minddot/hw/README.md

# MindDot Hardware

## Components

- ESP32-C3-WROOM-02
- AHT10
- LIS2DH12
- HX6306P332MR
