minddot/hw/esp32c3/esp32c3.kicad_pcb

## KiCad design esp32c3/esp32c3.kicad_pcb (2022-04-22)

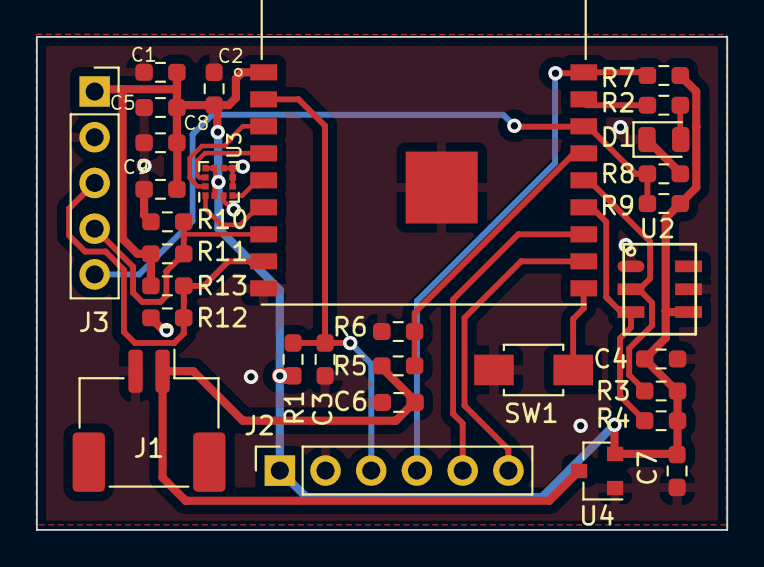
[picture p1: board esp32c3.kicad_pcb from above]

Board: 2 copper layers, 38.4 x 27.4 mm, 31 parts (0 on the bottom side), 20 nets.

Parts:
C1, C3, C5: 10uF; R_0603_1608Metric_Pad0.98x0.95mm_HandSolder
C2, C8, C9: 0.1uF; R_0603_1608Metric_Pad0.98x0.95mm_HandSolder
C4: 100nF; R_0603_1608Metric_Pad0.98x0.95mm_HandSolder
C6, C7: 1uF; R_0603_1608Metric_Pad0.98x0.95mm_HandSolder
D1: LED_RED; LED_0805_2012Metric
J1: A1501WR-S-2P; JST_ZE_BM02B-ZESS-TBT_1x02-1MP_P1.50mm_Vertical
J2: Conn_01x06; PinSocket_1x06_P2.54mm_Vertical
J3: Conn_01x05; PinSocket_1x05_P2.54mm_Vertical
R1: 12k; R_0603_1608Metric_Pad0.98x0.95mm_HandSolder
R2, R3, R4: 10k; R_0603_1608Metric_Pad0.98x0.95mm_HandSolder
R5, R8, R9, R10, R11, R12, R13: 100k; R_0603_1608Metric_Pad0.98x0.95mm_HandSolder
R6: 200k; R_0603_1608Metric_Pad0.98x0.95mm_HandSolder
R7: 5.1k; R_0603_1608Metric_Pad0.98x0.95mm_HandSolder
SW1: wake up; SW-SMD_2PIN-L4.05-W3.00-L
U1: ESP32-C3-WROOM-02
U2: AHT10
U3: LIS2DH; LGA-12_2x2mm_P0.5mm
U4: HX6306; SOT-23

Connections:
3.3V: C1.1, C2.1, C4.1, C5.1, C7.1, C8.1, C9.1, J2.1, J3.1, R1.1, R3.1, R4.1, R7.2, R9.2, R11.2, R13.2, U1.1 (3V3), U2.4 (VDD), U3.2 (~CS), U3.9 (Vdd), U3.10 (Vdd_IO), U4.2 (VOUT)
ADC: R5.2, R6.1, U1.15 (IO3)
EN: C3.1, J2.3, R1.2, U1.2 (EN)
GND: C1.2, C2.2, C3.2, C4.2, C5.2, C6.2, C7.2, C8.2, C9.2, D1.1 (K), J1.2, J2.2, J3.2, R6.2, R8.2, R10.2, R12.2, SW1.1, U1.9 (GND), U1.19 (GND), U2.1 (ADR), U2.5 (GND), U3.3 (SA0/SDO), U3.5 (RES), U3.6 (GND), U3.7 (GND), U3.8 (GND), U4.1 (GND)
INT: SW1.2, U1.10 (IO10)
INT1: U1.3 (IO4), U3.12 (INT1)
INT2: U1.4 (IO5), U3.11 (INT2)
IO0: J2.4, R7.1, U1.18 (IO0)
IO2: J3.5, R8.1, R9.1, U1.16 (IO2)
IO8: J3.4, R10.1, R11.1, U1.7 (IO8)
IO9: J3.3, R12.1, R13.1, U1.8 (IO9)
LED: R2.1, U1.17 (IO1)
unnamed: D1.2 (A), R2.2
RXD: J2.6, U1.11 (RXD)
SCL: U1.6 (IO7), U3.1 (SCL/SPC)
SCL_AHT10: R4.2, U1.13 (IO18), U2.3 (SCL)
SDA: U1.5 (IO6), U3.4 (SDA/SDI)
SDA_AHT10: R3.2, U1.14 (IO19), U2.2 (SDA)
TXD: J2.5, U1.12 (TXD)
V_In: C6.1, J1.1, R5.1, U4.3 (VIN)
