minddot/hw/(threads)

Thread 1 (2021-02-21):

[feature] getting started

bovi, 2021-02-21:
Add a getting started overview with the following content:

* how to add batteries
* how to connect the first-time
* how to access the web ui

bovi, 2021-12-08:
first schematic version checked in under: 7d61a6ebe9fcdbcbea0f9ce73e197d6e1afc682e

bovi, 2021-12-13:
push button, programming circuit fix and voltage measurement implemented under: 2b1e118047ebf2faca86f61bb3a7689e9192f407

bovi, 2021-12-22:
Review suggestions:

- R4 and R5 seem to be there in order to measure V_in. I suggest to make the values a little bit higher, in order to reduce the power consumption a bit. In the schematic, there would be more than 1mA continuously flowing through those resistors. Maybe 100k & 200k would be better?
- If we are short of IOs, it’s okay to leave INT2 of LIS2DH unconnected, but if we still have IOs free, we could also connect it.
- On page 8 of the AHT10 datasheet it says that the AHT10 can not be on the same i2c bus with other devices. Unless I am reading the datasheet wrong, we would have to create two i2c busses.
- According to the ESP datasheet, IO2, IO8 and IO9 are used for bootstrapping during boot, so I think we probably cannot use them in the way it’s done in the schematic. (See the section “Strapping Pins” in the datasheet.)
- I suggest to lead unused IOs to some pinheader pads so that we can easily access them, e.g.. for debugging purposes.
- An optional LED on one of the IOs might be nice.

Thread 3 (2021-02-21):

[doc] Add component datasheets

bovi, 2021-02-21:
Add datasheets of the used components.

bovi, 2021-09-14:
Datasheets for current LDO, Sensor and SoCs were uploaded. selection for SoC is still open.

Closed 2021-09-14.

Thread 4 (2021-09-13):

[doc] Add BOM

bovi, 2021-09-13:
Add BOM for the new open-hardware generation (SoC, Sensors, LDOs, etc.)

bovi, 2021-11-27:
added accelerometer, temperature sensor, LDO and SoC under [datasheets](https://github.com/minddot/hw/tree/main/datasheets)

Closed 2021-11-27.
