minddot/hw/(commit log)

2021-09-14 add datasheets for MCP and ESP32
2021-09-14 add sensor datasheets
2021-09-14 add additional SoCs for ESP32
2021-11-29 Add Components
    Add BOM close #4
2021-12-08 finish schematic
    [esp32c3.kicad_pcb, esp32c3.kicad_sch]
2021-12-13 add wake up, voltage measurement
    [esp32c3.kicad_sch]
2022-01-03 finish first version of PCB
    [esp32c3.kicad_pcb, esp32c3.kicad_sch]
2022-01-06 Place components on one side
    [esp32c3.kicad_pcb, esp32c3.kicad_sch]
2022-04-21 update readme for accelerometer component
2022-04-22 Complete LIS2DH12 modification
    [esp32c3.kicad_pcb, esp32c3.kicad_sch]
2022-04-22 prepare v2.0-alpha-1 for fabrication
    [esp32c3-B_Cu.gbr, esp32c3-B_Mask.gbr, esp32c3-B_Paste.gbr, esp32c3-B_Silkscreen.gbr, esp32c3-Edge_Cuts.gbr, esp32c3-F_Cu.gbr, esp32c3-F_Mask.gbr, esp32c3-F_Paste.gbr]
